tsbyinchei/IoMT-ECG-FallDetection/(commit log)

2026-09-29 Initial commit: Complete IoMT ECG & Fall Detection System (ESP32-C3, ESP32 Gateway, MATLAB)
2026-09-29 docs: credit author Nguyễn Văn Tuấn Sỹ (@tsbyinchei)
2026-09-29 feat: 3-phase fall verification with tilt & gyro immobility, and Telegram alert integration
2026-09-29 docs: credit reference to Circuit-Digest/Elderly-Fall-Detection-System
2026-09-29 feat: enable MQTT cloud mode pointing to 1Panel EMQX broker at 192.168.1.36
    [ESP32.ino, secrets_example.h]
2026-09-29 feat: upgrade ESP32 Gateway to native WSS MQTT client connecting via Cloudflare Tunnel at wss://mqtt.tsbyin.dev/mqtt
2026-09-29 docs: replace personal subdomains with generic yourdomain.com placeholders
    [ESP32.ino, secrets_example.h]
2026-10-07 Update ESP32 Example.ino
2026-10-09 feat(gateway): implement remote mute via MQTT and local button buzzer control
    [ESP32 Example.ino]
2026-10-09 feat(sensor-node): add 2-stage post-fall inactivity verification with adaptive gravity baseline
2026-10-09 feat(web): add brand assets, PWA offline support, remote mute UI, and 2-stage fall simulator
2026-10-09 fix(telemetry): resolve MQTT WSS connectivity, WiFi resilience and OLED diagnostics
    [ESP32 Example.ino]
2026-10-09 fix(esp32): embed ISRG Root X1 CA and system time calibration to resolve TLS 0x7780 handshake alert
    [ESP32 Example.ino]
2026-10-09 fix(pwa): filter non-http requests from service worker cache to avoid chrome-extension put error
2026-10-09 fix(esp32): add explicit WSS transport parameters, DNS 8.8.8.8, and lifecycle debug logs
    [ESP32 Example.ino]
2026-10-09 fix(esp32): keep single uri configuration in mqtt_cfg to prevent ESP_ERR_INVALID_ARG
    [ESP32 Example.ino]
2026-10-09 fix(esp32): enable SNI and attach full Let's Encrypt Root CA (X1 & X2) for Cloudflare Tunnel
    [ESP32 Example.ino]
2026-10-09 fix(esp32): mute data stream on serial, update epoch time for ssl cert, enable verbose tls diagnostics
    [ESP32 Example.ino]
2026-10-09 fix(web): sync 250Hz oscilloscope sweep and center flatline when leads off
2026-10-09 fix(esp32c3): expand MPU range to +/-8G, 400kHz I2C, 125Hz sampling with peak SMV window capture
    [ESP32C3 Example.ino]
2026-10-09 fix(oled,web): update fall threshold display to 2.2g and enable continuous latching alarm
    [ESP32 Example.ino]
2026-10-09 feat(ecg): implement 50Hz notch filter, baseline wander removal, and hospital-grade phosphor oscilloscope rendering
2026-10-09 feat(ecg): align Pan-Tompkins pipeline with MATLAB butter(2, [5 15]) and 7-beat median RR filter
2026-10-09 fix(web, matlab, esp32): cache busting v1.7, enable serial stream, and auto MQTT UDP bridge for MATLAB
    [ESP32 Example.ino]
2026-10-09 feat: smart multi-wifi roaming for C3 and immediate latching buzzer alarm on Gateway
    [ESP32 Example.ino, ESP32C3 Example.ino]
2026-10-09 fix(c3): remove duplicate setup block causing nested function definition error
    [ESP32C3 Example.ino]
2026-10-09 fix(c3): fix wifi scan while connecting conflict, add connection wait and auto fallback roaming
    [ESP32C3 Example.ino]
2026-10-09 fix(c3): allow open security AP with setMinSecurity(WIFI_AUTH_OPEN) and fix soft disconnect
    [ESP32C3 Example.ino]
2026-10-09 fix(c3): restore rock-solid direct WiFi connection to Gateway AP and add clean fallback
    [ESP32C3 Example.ino]
2026-10-09 fix(fall): implement true 2-stage fall analysis without premature alarm on impact
    [ESP32 Example.ino, ESP32C3 Example.ino]
2026-10-12 fix(firmware-c3): implement non-blocking fail-safe sampling and 2-stage fall detection
    - Remove blocking delay(100) and return on Wi-Fi reconnect so ECG 250Hz sampling and MPU-6050 fall analysis execute continuously 24/7 without interruption.
    - Implement true 2-stage fall verification algorithm: Stage 1 candidate impact detection (SMV >= 2.8g) and Stage 2 post-fall assessment after 2.5s window checking both posture tilt (>= 40 deg) and immobility (Gyro < 45 deg/s).
    - Implement Smart Leads-off detection combining hardware LO+/LO- pins and ADC rail saturation checks to resolve GPIO 2 strapping pin pull-up on ESP32-C3 SuperMini.
    - Add comprehensive mathematical formulas, register documentation,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
2026-10-12 fix(firmware-gateway): drain UDP queue, optimize OLED refresh, and enrich DSP comments
    - Drain UDP socket buffer using 'while (udp.parsePacket() > 0)' loop to eliminate socket queue exhaustion and packet drops in LwIP stack.
    - Optimize OLED SH1106 refresh interval from 50ms (20 FPS) to 100ms (10 FPS) to prevent I2C bus contention and free CPU time for real-time network stacks.
    - Add in-depth mathematical documentation for Biquad IIR Notch 50Hz difference equations and Pan-Tompkins 5-stage QRS detection pipeline (derivative, squaring, MWI, adaptive thresholding, 7-sample median RR).
    - Document continuous fall siren latching, local BOOT button mute, remote MQTT command control, and Telegram/Za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
2026-10-18 docs: integrate power budget, CRC-16 integrity, and TSDB tiered storage into thesis documentation
2026-10-18 feat(firmware): implement 80MHz power optimization and 62-byte CRC-16 protocol
2026-10-20 feat(web): add mobile responsive sidebar drawer, fix replay auto-loop, and correct initial electrode state
2026-10-20 fix(responsive): optimize header and drawer for all screen sizes (Surface Pro, iPhone, Android), fix InfluxDB CORS with no-cors probe and prevent SW cross-origin intercept
2026-11-03 feat(dsp): toi uu bo loc Pan-Tompkins SOS 5-15Hz, che do lam sang va PWA v2.1
2026-11-07 docs: align tachycardia threshold to 105 BPM and clarify breadboard PoC power budget
