tsbyinchei/IoMT-ECG-FallDetection/(notices)

Notices in the files:
README.md:
License: MIT
